seth-sievers/power-filter/README.md

# power-filter
A basic pcb to filter high frequency noise and regulate voltage for sensitive instrumentation

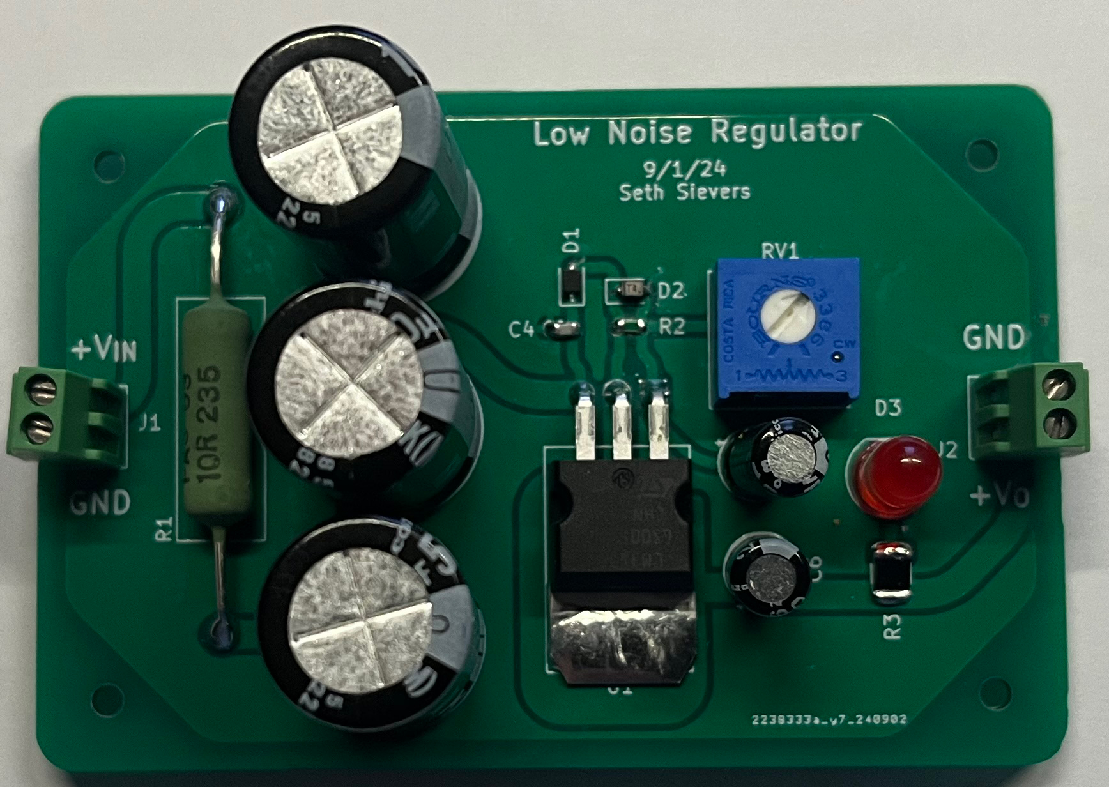
[picture p1: LowNoiseRegulator.jpg]
