seth-sievers/power-filter/kicad/footprints/c-282834-2-c-3d.stp

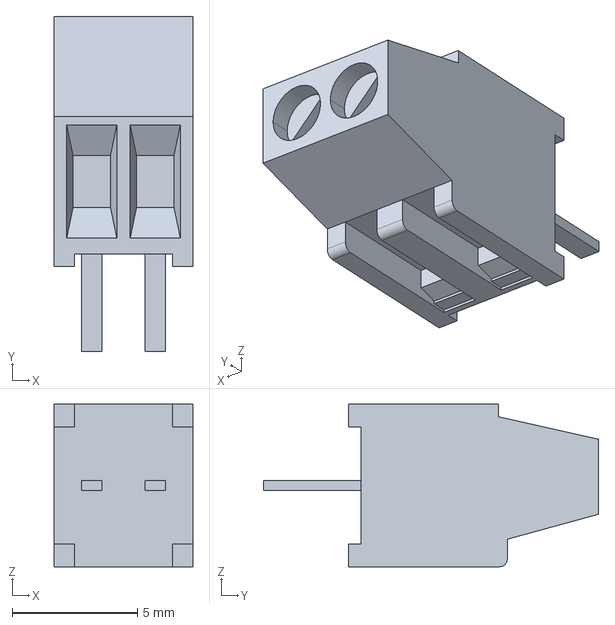
[picture p2: CAD file, 2024-09-01]
kicad/footprints/c-282834-2-c-3d.stp
5.54 x 13.4 x 6.50 mm
