seth-sievers/power-filter/ltspice/power-filter.asc

C1: polcap; 22µ; V=50 Irms=170m Rser=1 Lser=0 mfg="Nichicon" pn="UPG1H220MPH" type="Al electrolytic"
C2: cap; 10n; V=50 Irms=0 Rser=0.0124 Lser=188p mfg="Würth Elektronik" pn="885012009023 WCAP-CSGP 1210" type="NP0"
C3: polcap; 10µ; V=50 Irms=50m Rser=2.2 Lser=0 mfg="Nichicon" pn="UPR1H100MAH" type="Al electrolytic"
C4: polcap; 1m; V=50 Irms=1.68 Rser=0.04 Lser=0
C5: polcap; 1m; V=50 Irms=1.68 Rser=0.04 Lser=0
C6: polcap; 1m; V=50 Irms=1.68 Rser=0.04 Lser=0
D1: diode; 1N4148
D2: diode; 1N4148
D4: diode; 1N4148
R1: res; 240; tol=1 pwr=0.21
R2: res; 3200; tol=1 pwr=0.21
R3: res; 10; tol=1 pwr=3
R4: res; 2.21K; tol=1 pwr=0.1
R5: res; 170
U2: LM317_TI
V1: voltage; 24
V2: voltage; SINE(0 500m {freq} 0)
Named nets: 0, Vin, Vout, V_lpf, V_ADJ
ADJ Regulator
Datasheet Calcluation: 18.2V
LPF
.tran 0 1s 0 100u startup uic
.inc LM317_TRANS.LIB
;ac dec 1000 1m 20k
;op dec 1000 1m 20k
.step param freq list 1 10 60 1000 10000
