seth-sievers/power-filter/kicad/filter.kicad_pcb

## KiCad design kicad/filter.kicad_pcb (2024-09-01)

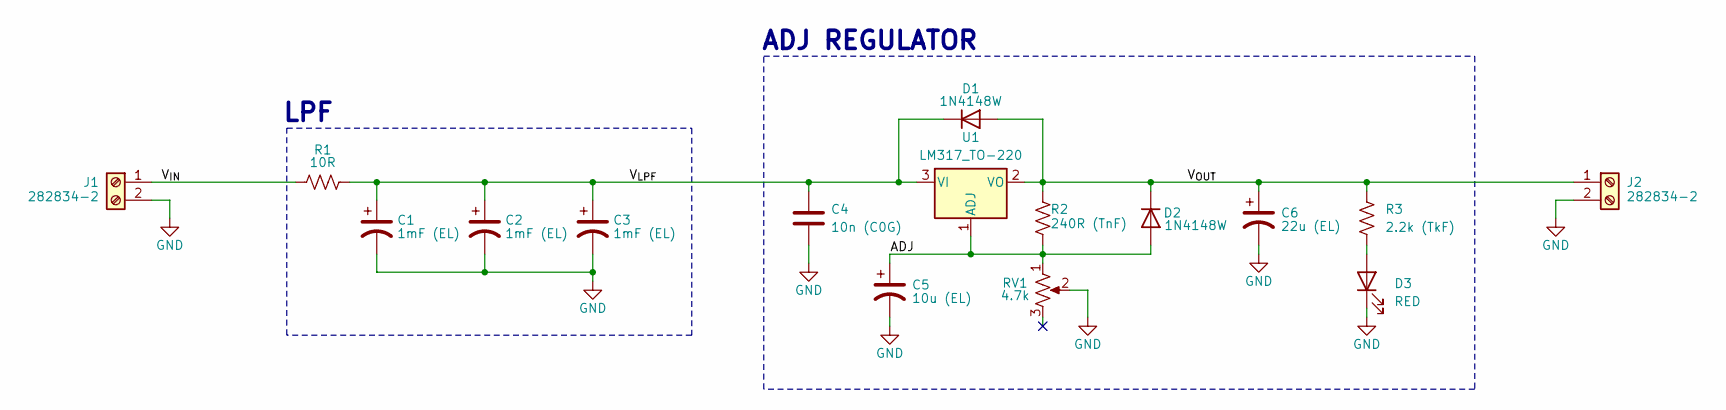
[picture p3: schematic filter.kicad_sch, PWR FILTER]

Parts:
C1, C2, C3: 1mF (EL); CP_Radial_D12.5mm_P5.00mm
C4: 10n (C0G); C_0603_1608Metric
C5: 10u (EL); CP_Radial_D5.0mm_P2.00mm
C6: 22u (EL); CP_Radial_D5.0mm_P2.50mm
D1, D2: 1N4148W; D_SOD-323
D3: RED; LED_D5.0mm
J1, J2: 282834-2; TerminalBlock_TE_282834-2_1x02_P2.54mm_Horizontal
R1: 10R; R_Axial_DIN0617_L17.0mm_D6.0mm_P30.48mm_Horizontal
R2: 240R (TnF); C_0603_1608Metric
R3: 2.2k (TkF); R_1210_3225Metric
RV1: 4.7k; Potentiometer_Bourns_3386P_Vertical
U1: LM317_TO-220; TO-220-3_Horizontal_TabDown

Connections:
/ADJ: C5.1, D2.2 (A), R2.1, RV1.1, U1.1 (ADJ)
/V_{IN}: J1.1, R1.1
/V_{LPF}: C1.1, C2.1, C3.1, C4.1, D1.1 (K), R1.2, U1.3 (VI)
/V_{OUT}: C6.1, D1.2 (A), D2.1 (K), J2.1, R2.2, R3.1, U1.2 (VO)
GND: C1.2, C2.2, C3.2, C4.2, C5.2, C6.2, D3.1 (K), J1.2, J2.2, RV1.2
unnamed: D3.2 (A), R3.2

Notes on the sheet:
ADJ REGULATOR
LPF

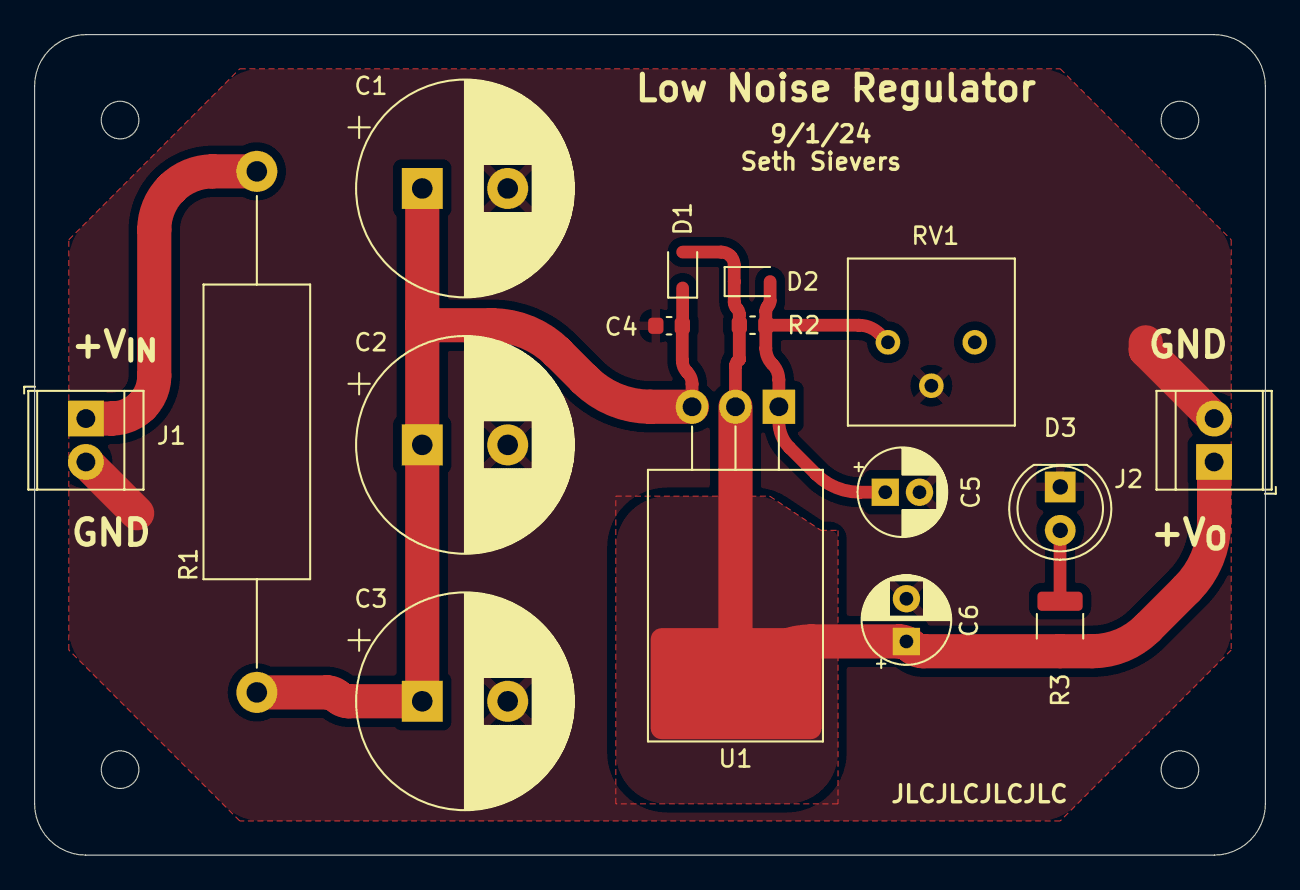
[picture p4: board filter.kicad_pcb from above]

Board: 2 copper layers, 72.0 x 48.0 mm, 16 parts (0 on the bottom side), 6 nets.
